garrettsworkshop/Mouserial-prototype/Documentation/Mouserial-render.png

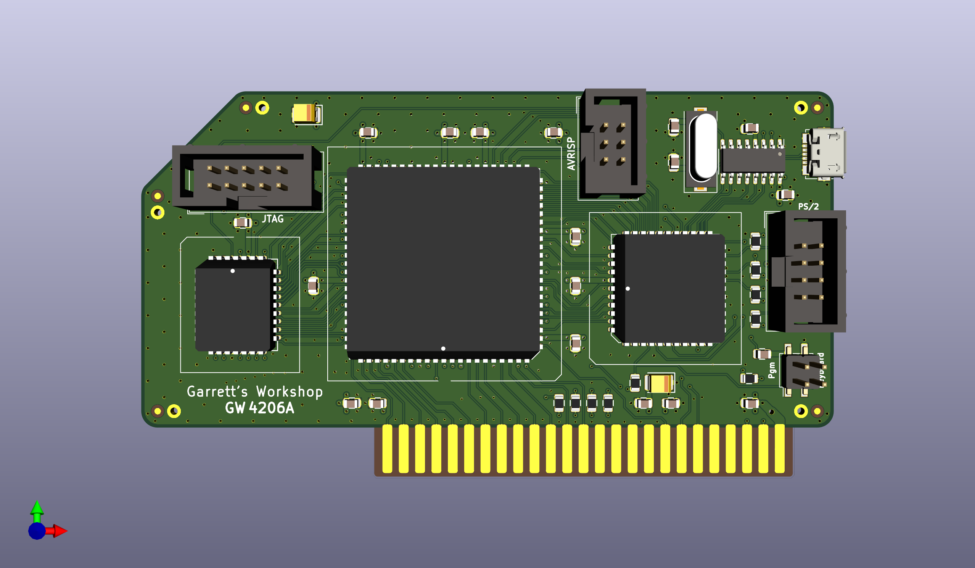
Documentation/Mouserial-render.png
