garrettsworkshop/Mouserial-prototype/(commit log)

2019-06-24 Hardware done?
    [Mouserial.kicad_pcb, Mouserial.sch]
2019-06-25 Cleaned up schematic
    [Docs.sch, Mouserial.kicad_pcb, Mouserial.sch]
2019-06-25 Few more stitching via changes
    [Mouserial.kicad_pcb]
2019-07-30 Submitted to JLCPCB
    [Docs.sch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]
2019-12-21 Adapter stuff, avr
    [Docs.sch, Mouserial.sch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]
